anxelito/EspNotificaciones/docs/designs/gato/hero.png

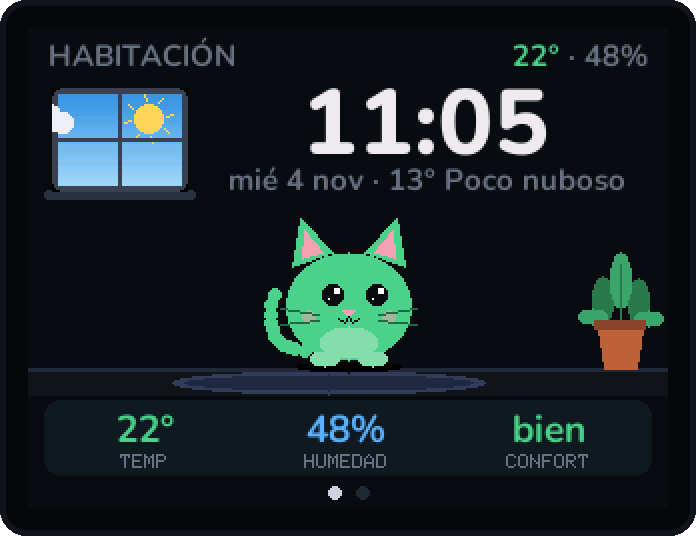
docs/designs/gato/hero.png
