anxelito/EspNotificaciones/docs/designs/perro/hero.png

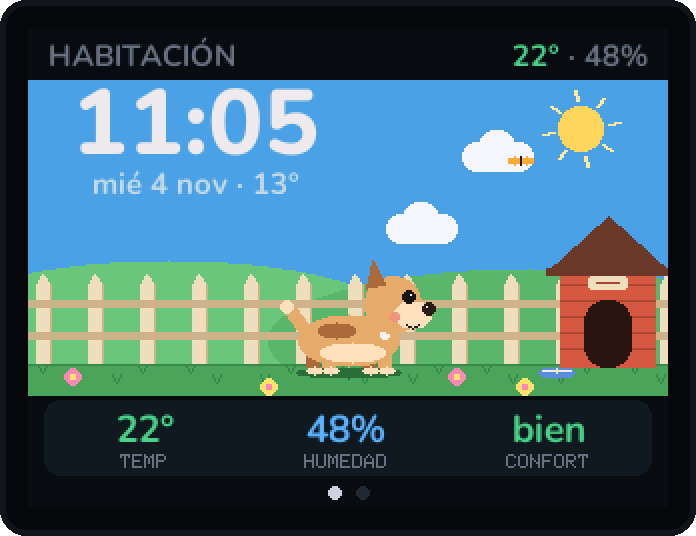
docs/designs/perro/hero.png
