anxelito/EspNotificaciones/docs/designs/pez/hero.png

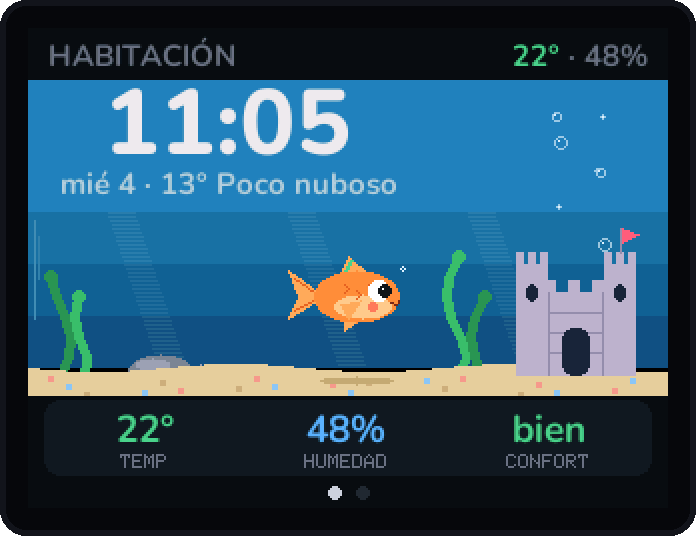
docs/designs/pez/hero.png
