anxelito/EspNotificaciones/docs/designs/pinguino/hero.png

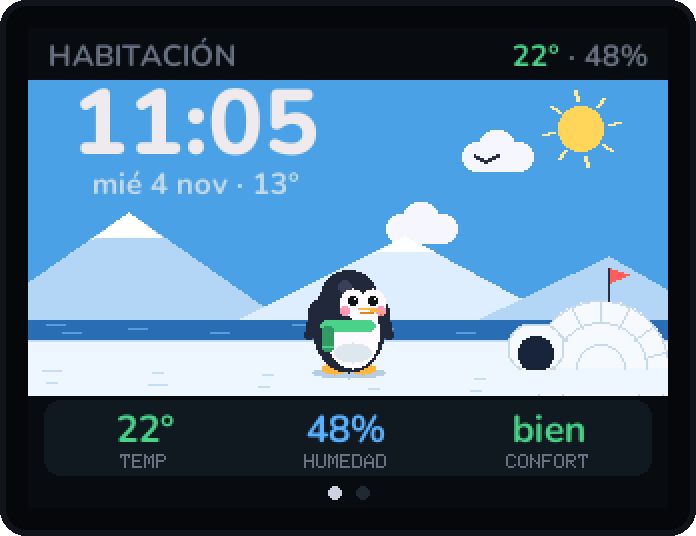
docs/designs/pinguino/hero.png
