anxelito/EspNotificaciones/docs/designs/rana/hero.png

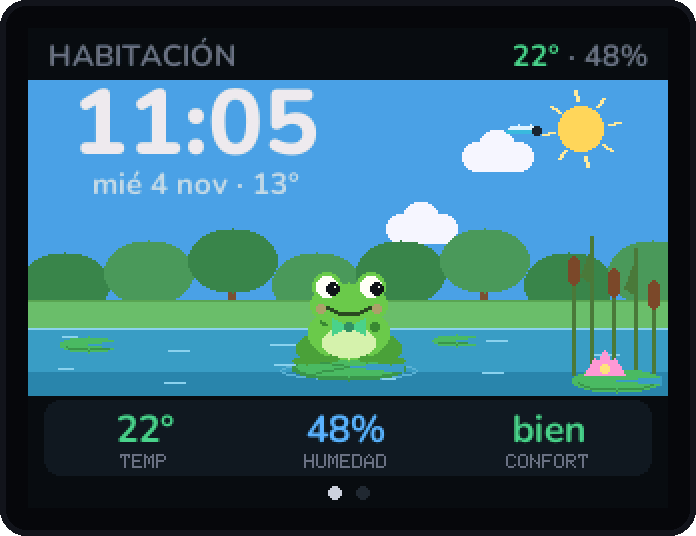
docs/designs/rana/hero.png
