anxelito/EspNotificaciones/firmware/src/main.ino

// firmware/src/main.ino
// Core 1 (loop): touch, DHT11, cat/screen state and all drawing. All
// networking lives in the core-0 worker (net/networker.*); loop() only reads
// its published snapshot and never blocks on HTTP.
#include "config.h"
#include "display.h"
#include "tasks.h"
#include "network.h"
#include "nowplaying.h"
#include "net/networker.h"
#include "logic/room.h"
#include "logic/gesture.h"
#include "logic/ui_state.h"
#include "logic/cat_state.h"
#include "logic/cat_behavior.h"
#include "hw/sensors.h"
#include "hw/touch.h"
#include "hw/backlight.h"
#include "ui/theme.h"
#include "ui/chrome.h"
#include "ui/screen_tasks.h"
#include "ui/screen_music.h"
#include "ui/screen_room.h"
#include "ui/cat_draw.h"
#include "ui/room_scene.h"
#include <SPIFFS.h>
#include <WiFi.h>

#define LOOP_IDLE_MS     2      // per-iteration yield (touch polled every pass)
#define BL_AWAKE         255
#define BL_ASLEEP        40

// --- live state -------------------------------------------------------------
static RoomReading     room;
static GestureDetector gesture;
static UiState         ui;
static CatState        cat;
static CatBehavior     catBeh;
static int             catDrawnX = ROOM_CAT_X;
static NetSnapshot     snap;             // latest copy from the worker

// --- what is currently on the glass -----------------------------------------
// Everything the header shows; redraw it only when this changes.
struct HeaderKey {
    char     title[32];
    bool     online, timeKnown, playing, haveRoom;
    int      hour, minute, temp, hum;
    Comfort  comfort;                    // temp colour can change without int change
    uint16_t bg;                         // music screen tints the header
    bool     showTime;
};

// What the room's clock/info line shows; redraw it only when this changes.
struct ClockKey {
    bool timeKnown;
    int  hour, minute, wday, mday, mon;
    bool weatherOk;
    int  code, temp;
};

static bool       drawnOnce       = false;
static Screen     drawnScreen     = Screen::ROOM;
static int        drawnDotsCount  = 0;
static uint16_t   drawnDotsBg     = 0;
static HeaderKey  drawnHeader;
static bool       headerDirty     = true;
static ClockKey   drawnClock;
static uint32_t   lastCatFrame    = 0;
static uint32_t   lastWindowFrame = 0;
static int        drawnLook       = -1;  // night*8 + comfort of the static scene
static uint32_t   lastPulse       = 0;
static int        drawnBacklight  = -1;
static TaskItem   drawnTasks[MAX_TASKS];
static int        drawnTaskCount  = -1;
static NowPlaying drawnNp;
static uint32_t   drawnSongVer    = 0;
static int        drawnProgSec    = -1;
static uint32_t   lastEqFrame     = 0;
// Progress estimate between polls: last reported value + time since then.
static int        npProgSeen      = -1;
static uint32_t   npProgAt        = 0;
static uint32_t   npProgSong      = 0;

// "Nueva tarea" toast over the header.
static int        maxTaskIdSeen   = -1;  // -1 until the first online task list
static bool       toastOn         = false;
static bool       toastDrawn      = false;
static uint32_t   toastUntil      = 0;
static char       toastText[64];

// Local artwork copy (core 1 only; decoded by TJpg on this core)
static uint8_t*   artworkBuf      = nullptr;
static int        artworkLen      = 0;
static uint32_t   artworkVersion  = 0;   // songVersion artworkBuf belongs to

static int doneCount() {
    int n = 0;
    for (int i = 0; i < snap.taskCount; i++)
        if (strcmp(snap.tasks[i].status, "done") == 0) n++;
    return n;
}

static uint16_t screenBg() {
    return ui.screen == Screen::MUSIC ? musicBg(snap.np) : C_BG;
}

static void buildHeaderKey(HeaderKey& k, bool timeKnown, int hour, int minute, bool fresh) {
    memset(&k, 0, sizeof(k));
    switch (ui.screen) {
        case Screen::ROOM:  strlcpy(k.title, "HABITACIÓN", sizeof(k.title)); break;
        case Screen::TASKS:
            if (snap.taskCount > 0)
                snprintf(k.title, sizeof(k.title), "TAREAS · %d/%d", doneCount(), snap.taskCount);
            else
                strlcpy(k.title, "TAREAS", sizeof(k.title));
            break;
        case Screen::MUSIC: strlcpy(k.title, "SONANDO", sizeof(k.title)); break;
    }
    k.online    = snap.online;
    k.timeKnown = timeKnown;
    k.hour      = timeKnown ? hour : 0;
    k.minute    = timeKnown ? minute : 0;
    k.playing   = snap.playing;
    k.haveRoom  = room.everOk && fresh;
    if (k.haveRoom) {
        k.temp    = (int)lroundf(room.tempC);
        k.hum     = (int)lroundf(room.humidity);
        k.comfort = classifyTemp(room.tempC);
    }
    k.bg = screenBg();
    k.showTime = ui.screen != Screen::ROOM;
    if (!k.showTime) { k.hour = 0; k.minute = 0; }   // minute ticks need no header redraw
}

static void buildScene(SceneInfo& s, bool timeKnown, int hour, int minute) {
    memset(&s, 0, sizeof(s));
    s.timeKnown = timeKnown && clockGetDate(&s.wday, &s.mday, &s.mon);
    s.hour = hour;
    s.minute = minute;
    s.weatherOk   = snap.weather.ok;
    s.weatherCode = snap.weather.code;
    s.outTemp     = snap.weather.temp;
    s.night       = timeKnown && (hour < 7 || hour >= 20);
    s.comfort     = roomIsFresh(room, millis()) ? classifyTemp(room.tempC) : Comfort::UNKNOWN;
}

static void buildClockKey(ClockKey& k, const SceneInfo& s) {
    memset(&k, 0, sizeof(k));
    k.timeKnown = s.timeKnown;
    if (s.timeKnown) {
        k.hour = s.hour; k.minute = s.minute;
        k.wday = s.wday; k.mday = s.mday; k.mon = s.mon;
    }
    k.weatherOk = s.weatherOk;
    if (s.weatherOk) { k.code = s.weatherCode; k.temp = (int)lroundf(s.outTemp); }
}

static int estimatedProgress(uint32_t now) {
    if (snap.np.progress_ms != npProgSeen || snap.songVersion != npProgSong) {
        npProgSeen = snap.np.progress_ms;
        npProgSong = snap.songVersion;
        npProgAt   = now;
    }
    if (snap.np.duration_ms <= 0) return 0;
    long p = (long)npProgSeen + (long)(now - npProgAt);
    return p > snap.np.duration_ms ? snap.np.duration_ms : (int)p;
}

static bool artworkReady() {
    return artworkBuf && artworkLen > 0 && artworkVersion == snap.songVersion;
}

// Copy the artwork once per song, only after the worker has published the
// artwork for the current songVersion (cheap peek first, no big copy).
static bool pickUpArtwork() {
    if (!artworkBuf || artworkVersion == snap.songVersion) return false;
    if (netArtworkVersion() != snap.songVersion) return false;
    uint32_t v = 0;
    int n = netCopyArtwork(artworkBuf, MAX_ARTWORK_BYTES, &v);
    if (v != snap.songVersion) return false;   // raced with a newer song
    artworkVersion = v;
    artworkLen     = n;
    return n > 0;
}

// New pending task (id above any seen before) -> toast. The first task list
// after boot only sets the baseline.
static void checkNewTask(uint32_t now) {
    if (!snap.online || snap.taskCount < 0) return;
    int maxId = 0;
    const TaskItem* newest = nullptr;
    for (int i = 0; i < snap.taskCount; i++) {
        if (snap.tasks[i].id > maxId) maxId = snap.tasks[i].id;
        if (snap.tasks[i].id > maxTaskIdSeen && strcmp(snap.tasks[i].status, "pending") == 0 &&
            (!newest || snap.tasks[i].id > newest->id))
            newest = &snap.tasks[i];
    }
    if (maxTaskIdSeen >= 0 && newest) {
        strlcpy(toastText, newest->text, sizeof(toastText));
        toastOn    = true;
        toastDrawn = false;
        toastUntil = now + TOAST_MS;
    }
    if (maxId > maxTaskIdSeen) maxTaskIdSeen = maxId;
}

// Robot roams horizontally, staying clear of the control panel.
static const int CAT_MIN_X = ROOM_BOT_MIN_X;
static const int CAT_MAX_X = ROOM_BOT_MAX_X;

// fullRedraw: the room was just painted, so no trail needs erasing.
static void drawCatFrame(uint32_t now, bool fullRedraw) {
    behaviorTick(catBeh, now, cat.mood == CatMood::IDLE && !toastOn, CAT_MIN_X, CAT_MAX_X);

    CatPose p;
    p.mood      = cat.mood;
    p.blink     = catBlinking(cat, now);
    p.humid     = roomIsFresh(room, now) ? classifyHumidity(room.humidity) : HumidMood::UNKNOWN;
    Comfort comfort = roomIsFresh(room, now) ? classifyTemp(room.tempC) : Comfort::UNKNOWN;
    p.body      = comfortColor(comfort);  // catDraw darkens when SLEEPING
    p.nowMs     = now;
    p.moodSince = cat.since;
    p.act       = catBeh.act;
    p.actPhase  = behaviorPhase(catBeh, now);
    p.facing    = catBeh.facing;
    p.look      = catBeh.look;
    p.comfort   = comfort;
    p.envelope  = toastOn && !catIsAsleep(cat);

    // Moving sprite: repaint the room in the strip it just left.
    int x = catBeh.x;
    if (!fullRedraw && x != catDrawnX) {
        if (x > catDrawnX) sceneRepaintRect(catDrawnX, ROOM_CAT_Y, x - catDrawnX, CAT_H);
        else               sceneRepaintRect(x + CAT_W, ROOM_CAT_Y, catDrawnX - x, CAT_H);
    }
    catDraw(p, x, ROOM_CAT_Y);
    catDrawnX = x;
}

static void render(uint32_t now, bool timeKnown, int hour, int minute, bool newArt) {
    const bool fresh       = roomIsFresh(room, now);
    const bool screenNew   = !drawnOnce || ui.screen != drawnScreen;
    const int  dotsCount   = uiScreenCount(snap.playing);

    // Header (or the toast over it).
    if (toastOn && (int32_t)(now - toastUntil) >= 0) {
        toastOn = false;
        headerDirty = true;
    }
    if (toastOn) {
        if (!toastDrawn) {
            drawToast("Nueva tarea", toastText, C_OK);
            toastDrawn = true;
        }
    } else {
        HeaderKey hk;
        buildHeaderKey(hk, timeKnown, hour, minute, fresh);
        if (screenNew || headerDirty || memcmp(&hk, &drawnHeader, sizeof(hk)) != 0) {
            HeaderInfo hi = {};
            hi.title     = hk.title;
            hi.online    = snap.online;
            hi.timeKnown = timeKnown;
            hi.hour      = hour;
            hi.minute    = minute;
            hi.playing   = snap.playing;
            hi.room      = &room;
            hi.roomFresh = fresh;
            hi.bg        = hk.bg;
            hi.showTime  = hk.showTime;
            drawHeader(hi);
            drawnHeader = hk;
            headerDirty = false;
        }
    }

    // Body.
    switch (ui.screen) {
        case Screen::ROOM: {
            SceneInfo sc;
            buildScene(sc, timeKnown, hour, minute);
            ClockKey ck;
            buildClockKey(ck, sc);
            int look = (sc.night ? 8 : 0) + (int)sc.comfort;
            if (screenNew || look != drawnLook) {      // whole room (rare)
                sceneSetLook(sc.night, sc.comfort);
                drawnLook = look;
                drawRoomScreen();                      // static room, invalidates strip
                drawRoomStrip(room, fresh);
                drawRoomClock(sc);
                drawnClock = ck;
                drawSceneAnim(now);
                lastWindowFrame = now;
                drawCatFrame(now, true);
                lastCatFrame = now;
            } else {
                if (memcmp(&ck, &drawnClock, sizeof(ck)) != 0) {
                    drawRoomClock(sc);
                    drawnClock = ck;
                }
                if ((now - lastWindowFrame) >= WINDOW_FRAME_MS) {
                    drawSceneAnim(now);
                    lastWindowFrame = now;
                }
                if ((now - lastCatFrame) >= CAT_FRAME_MS) {
                    drawRoomStrip(room, fresh);        // repaints changed columns only
                    drawCatFrame(now, false);
                    lastCatFrame = now;
                }
            }
            break;
        }

        case Screen::TASKS:
            if (screenNew || snap.taskCount != drawnTaskCount ||
                memcmp(snap.tasks, drawnTasks, sizeof(drawnTasks)) != 0) {
                drawTasksScreen(snap.tasks, snap.taskCount);
                memcpy(drawnTasks, snap.tasks, sizeof(drawnTasks));
                drawnTaskCount = snap.taskCount;
            } else if ((now - lastPulse) >= PULSE_FRAME_MS) {
                drawTasksPulse(now);
                lastPulse = now;
            }
            break;

        case Screen::MUSIC: {
            int prog = estimatedProgress(now);
            bool bgChanged = musicBg(snap.np) != musicBg(drawnNp);
            if (screenNew || snap.songVersion != drawnSongVer || bgChanged ||
                (newArt && artworkReady())) {          // artwork arrived after the text
                bool ok = artworkReady();
                drawMusicScreen(snap.np, ok ? artworkBuf : nullptr, ok ? artworkLen : 0, prog);
                drawnNp       = snap.np;
                drawnSongVer  = snap.songVersion;
                drawnProgSec  = prog / 1000;
                lastEqFrame   = now;
            } else {
                if ((now - lastEqFrame) >= EQ_FRAME_MS) {
                    drawMusicEq(snap.np, now);
                    lastEqFrame = now;
                }
                if (prog / 1000 != drawnProgSec || snap.np.duration_ms != drawnNp.duration_ms) {
                    drawMusicProgress(snap.np, prog);
                    drawnProgSec = prog / 1000;
                    drawnNp      = snap.np;
                }
            }
            break;
        }
    }

    // Page dots: on screen change, when music joins/leaves the cycle, or when
    // the music tint changes.
    uint16_t bg = screenBg();
    if (screenNew || dotsCount != drawnDotsCount || bg != drawnDotsBg) {
        drawPageDots(uiScreenIndex(ui.screen), dotsCount, bg);
        drawnDotsCount = dotsCount;
        drawnDotsBg    = bg;
    }

    drawnScreen = ui.screen;
    drawnOnce   = true;
}

void setup() {
    Serial.begin(115200);

    displayInit();
    // Cat sprite (~18 KB) first, before the worker and artwork buffers.
    uint32_t heapBefore = ESP.getFreeHeap();
    bool sprOk = catDrawInit();
    sceneInit();
    Serial.printf("[boot] cat sprite %s, heap %u -> %u B free (expect >= 40 KB)\n",
                  sprOk ? "OK" : "FAILED", (unsigned)heapBefore,
                  (unsigned)ESP.getFreeHeap());
    drawSplash("Iniciando...");

    sensorsInit();
    touchInit();
    backlightInit();

    SPIFFS.begin(true);  // format on first run if needed
    static TaskItem cached[MAX_TASKS];
    int cachedCount = loadTasks(cached);
    sortTasks(cached, cachedCount);

    artworkBuf = (uint8_t*)malloc(MAX_ARTWORK_BYTES);
    if (!artworkBuf) Serial.println("ERROR: no heap for artwork buffer");

    // Bring up the network stack here (core 1, before the worker exists) so
    // configTime() sets TZ without racing localtime_r() on the other core.
    WiFi.mode(WIFI_STA);
    clockBegin();

    netStart(cached, cachedCount);       // worker connects WiFi on core 0

    uint32_t now = millis();
    ui.screen      = Screen::ROOM;       // home
    ui.lastTouchMs = now;
    cat.since      = now;
    behaviorInit(catBeh, ROOM_CAT_X, esp_random(), now);
    Serial.printf("[boot] ready, heap %u B free\n", (unsigned)ESP.getFreeHeap());
}

void loop() {
    uint32_t now = millis();

    sensorsPoll(room, now);              // self-throttled to DHT_READ_MS

    // Touch every pass. snap.playing is from the previous pass (<= a few ms old).
    switch (gesture.update(touchPressed(), now)) {
        case Gesture::TAP:
            if (uiOnTap(ui, snap.playing, catIsAsleep(cat), now) == TapEffect::WOKE_CAT)
                catOnWakeTap(cat, now);
            break;
        case Gesture::LONG_PRESS:
            ui.lastTouchMs = now;        // any touch counts as activity
            if (ui.screen == Screen::ROOM) catOnPet(cat, now);
            break;
        default:
            break;
    }

    netGetSnapshot(&snap);

    int hour = 0, minute = 0;
    bool timeKnown = clockGetHM(&hour, &minute);

    catUpdate(cat, isSleepHour(timeKnown ? hour : -1), now);
    uiTick(ui, snap.playing, now);       // idle timeout / music ended -> ROOM

    int bl = catIsAsleep(cat) ? BL_ASLEEP : BL_AWAKE;
    if (bl != drawnBacklight) {
        backlightSet((uint8_t)bl);
        drawnBacklight = bl;
    }

    checkNewTask(now);
    bool newArt = pickUpArtwork();
    render(now, timeKnown, hour, minute, newArt);

    delay(LOOP_IDLE_MS);
}
