anxelito/EspNotificaciones/firmware/tools/snapshots/gen_readme.py

"""Writes README.md for a branch. usage: gen_readme.py <out README.md> <active id>"""
import sys

out, active = sys.argv[1], sys.argv[2]

DESIGNS = [
    ("robot", "E", "Robot en la estación", "design/robot",
     "Un robot que flota en una estación espacial, con un ojo de buey al espacio. El planeta cambia de color con la temperatura de la habitación y el panel parpadea.",
     "Vuela de lado a lado, escanea con la pantalla, se queda sin batería, estira los brazos y bota. Por la noche se sienta en su base a cargar, con gorro de dormir."),
    ("gato", "A", "Gatito en su cuarto", "design/gato",
     "El diseño original: una ventana con el cielo según la hora y el tiempo real, una alfombra y una planta.",
     "Pasea, mira alrededor, se lava, bosteza, se estira y salta. Por la noche se duerme en su cojín."),
    ("perro", "B", "Perrito en el jardín", "design/perro",
     "Exterior a pantalla completa. El cielo, las nubes, la lluvia (con charcos) y la nieve (en el césped y el tejado) siguen al tiempo real. Valla, colinas y caseta.",
     "Trota, levanta una oreja, se rasca, bosteza, hace la reverencia de juego y salta. Por la noche se enrosca en su cojín. Si hace frío, bufanda y vaho; si hace calor, lengua fuera."),
    ("pinguino", "C", "Pingüino en el polo", "design/pinguino",
     "Montañas de hielo, mar, nieve e iglú. Las noches despejadas tienen aurora boreal animada y, si la habitación está caliente, aparecen charcos de deshielo.",
     "Camina como un pato, se acicala, abre el pico, se pone de puntillas y salta. Duerme sentado con gorro. Con frío le salen chispitas de felicidad; con calor suda y se abanica."),
    ("pez", "D", "Pececito en la pecera", "design/pez",
     "Toda la pantalla es agua. Su color sigue a la temperatura de la habitación (más azul con frío, más verde con calor, más oscura de noche). Hay arena, algas, un castillo y burbujas.",
     "Nada de lado a lado, mira, echa burbujas, bosteza, abre las aletas y da un acelerón. Por la noche descansa en la arena."),
    ("rana", "F", "Rana en el estanque", "design/rana",
     "Estanque con nenúfares, juncos, flor de loto y árboles. Cuando llueve salen anillos en el agua. De día vuela una libélula y de noche hay luciérnagas.",
     "Rema en su nenúfar, caza moscas con la lengua, croa inflando la papada, estira las patas y pega saltos enormes. Por la noche duerme tapada con una hoja."),
]
STILLS = [("dia", "Día"), ("noche", "Noche"), ("frio", "Frío"), ("calor", "Calor"),
          ("carino", "Caricia"), ("tarea", "Nueva tarea")]

by_id = {d[0]: d for d in DESIGNS}
act = by_id[active]
L = []
w = L.append

PAGES = "https://anxelito.github.io/EspNotificaciones"
w('<h1 align="center">Panel de escritorio ESP32</h1>')
w("")
w('<p align="center"><b>Una mascota animada en tu mesa que te enseña la hora, el tiempo, la temperatura de tu cuarto, tus tareas de Telegram y lo que suena en Spotify.</b></p>')
w("")
w('<p align="center">')
w('  <a href="https://github.com/anxelito/EspNotificaciones/actions/workflows/tests.yml"><img alt="Tests" src="https://github.com/anxelito/EspNotificaciones/actions/workflows/tests.yml/badge.svg"></a>')
w('  <a href="LICENSE"><img alt="Licencia MIT" src="https://img.shields.io/badge/licencia-MIT-4fd18b"></a>')
w('  <img alt="ESP32" src="https://img.shields.io/badge/ESP32-PlatformIO-ff8a3d">')
w('  <img alt="Pantalla" src="https://img.shields.io/badge/pantalla-ST7789%202.4%22-5ab0ff">')
w('  <img alt="Backend" src="https://img.shields.io/badge/backend-FastAPI-b48cff">')
w('  <a href="%s/"><img alt="Pruébalo online" src="https://img.shields.io/badge/pru%%C3%%A9balo-online-ff6b8a"></a>' % PAGES)
w('</p>')
w("")
w('<p align="center"><img src="docs/designs/%s/hero.png" width="560" alt="Pantalla Habitación: %s"></p>' % (active, act[2]))
w("")
w('<p align="center">')
w('  <a href="#pruébalo">Pruébalo</a> ·')
w('  <a href="#diseños-de-la-habitación">Diseños</a> ·')
w('  <a href="#monta-el-tuyo">Monta el tuyo</a> ·')
w('  <a href="docs/INSTALACION.md">Guía completa</a> ·')
w('  <a href="#preguntas-frecuentes">Preguntas frecuentes</a>')
w('</p>')
w("")
w("> **Esta rama:** diseño **%s · %s**. Cada diseño de la pantalla Habitación vive en su propia rama `design/<nombre>`; consulta la [galería](#diseños-de-la-habitación)." % (act[1], act[2]))
w("")
w("## Pruébalo")
w("")
w("**Sin hardware, en el navegador:**")
w("- [**Simulador del panel**](%s/simulador/): el robot en su estación. Cambia la hora, la temperatura, la humedad y el tiempo; tócalo, acarícialo o mándale una tarea." % PAGES)
w("- [**Visor 3D de cajas**](%s/caja/): seis ideas de carcasa imprimible, para girarlas, cambiarles el color y la inclinación." % PAGES)
w("")
w("**Con hardware:** cuesta unos 15 € en piezas y se monta en una tarde. Ve a [Monta el tuyo](#monta-el-tuyo).")
w("")
w("## Qué hace")
w("")
w("| Pantalla | Qué muestra |")
w("|---|---|")
w("| **Habitación** | Reloj grande, fecha y tiempo de tu ciudad; la mascota con su escena; temperatura, humedad y confort del DHT11 |")
w("| **Tareas** | Las tareas que mandas al bot de Telegram, con prioridad, progreso y aviso cuando llega una nueva |")
w("| **Música** | La canción de Spotify (o Last.fm en la versión gratuita): portada grande, fondo difuminado, ecualizador y barra de progreso |")
w("")
w("- Un **toque** en el botón cambia de pantalla.")
w("- Si **mantienes pulsado** más de 1 s en Habitación, acaricias a la mascota.")
w("")
w("### Cómo reacciona la mascota")
w("")
w("- **Por la noche** (23:00–8:00) se duerme. Un toque la despierta un momento.")
w("- **Según la temperatura** de la habitación: tiembla con frío y suda con calor. Además, un detalle de su ropa (collar, bufanda, pajarita…) toma el color del confort.")
w("- **Cuando llega una tarea**, la trae en un sobre.")
w("")
w("## Diseños de la Habitación")
w("")
w("Hay seis mascotas con su propio escenario. Todas comparten el mismo comportamiento (estados de ánimo y acciones). Solo cambia el dibujo: `room_scene.*` y `cat_draw.cpp`.")
w("")
w("| | | |")
w("|:-:|:-:|:-:|")
for row in range(2):
    cells = []
    for d in DESIGNS[row * 3:(row + 1) * 3]:
        mark = " ⭐" if d[0] == active else ""
        cells.append('<img src="docs/designs/%s/dia.gif" width="260" alt="%s"><br>**%s · %s**%s<br>[`%s`](../../tree/%s)'
                     % (d[0], d[2], d[1], d[2], mark, d[3], d[3]))
    w("| " + " | ".join(cells) + " |")
w("")
w("⭐ = el diseño de esta rama. Los GIF son capturas reales del firmware: el código de dibujo se compila en el PC (ver [herramientas](#herramientas)).")
w("")
for d in DESIGNS:
    w("### %s · %s" % (d[1], d[2]))
    w("")
    w(d[4])
    w("")
    w("**Qué hace:** " + d[5])
    w("")
    w("| " + " | ".join(lab for _, lab in STILLS[:3]) + " |")
    w("|:-:|:-:|:-:|")
    w("| " + " | ".join('<img src="docs/designs/%s/%s.png" width="250" alt="%s, %s">' % (d[0], k, d[2], lab.lower()) for k, lab in STILLS[:3]) + " |")
    w("| **" + "** | **".join(lab for _, lab in STILLS[3:]) + "** |")
    w("| " + " | ".join('<img src="docs/designs/%s/%s.png" width="250" alt="%s, %s">' % (d[0], k, d[2], lab.lower()) for k, lab in STILLS[3:]) + " |")
    w("")
    w("<details><summary>De noche (animado)</summary>")
    w("")
    w('<img src="docs/designs/%s/noche.gif" width="400" alt="%s durmiendo">' % (d[0], d[2]))
    w("</details>")
    w("")
    w("Pruébalo: `git checkout %s`" % d[3])
    w("")

w("## Monta el tuyo")
w("")
w("### Lo que necesitas")
w("")
w("| Pieza | Aprox. | Notas |")
w("|---|---|---|")
w("| ESP32 DevKit (38 pines) | 6 € | cualquier ESP32-WROOM vale |")
w('| Pantalla ST7789 2.4" 240×320 (SPI) | 6 € | se usa en horizontal |')
w("| DHT11 | 1.5 € | temperatura y humedad |")
w("| TTP223 | 0.5 € | botón táctil; funciona a través de 1.2 mm de plástico. Opcional: sin él, el botón BOOT de la placa hace lo mismo |")
w("| Cables dupont y un cable micro-USB | | |")
w("| Impresora 3D | | opcional, para la [caja Mini TV retro](enclosure/retro_tv) |")
w("")
w("### Cableado")
w("")
w("| Pantalla ST7789 | ESP32 | | Sensor | ESP32 |")
w("|---|---|---|---|---|")
w("| VCC | 3V3 | | DHT11 DATA | GPIO27 |")
w("| GND | GND | | TTP223 I/O | GPIO32 |")
w("| SCL / SCK | GPIO18 | | VCC de ambos | 3V3 |")
w("| SDA / MOSI | GPIO23 | | GND de ambos | GND |")
w("| CS | GPIO15 | | | |")
w("| DC | GPIO2 | | | |")
w("| RES / RST | GPIO4 | | | |")
w("| BL / LED | 3V3 | | | |")
w("")
w("Más detalle (DHT11 suelto de 4 pines, regular el brillo) en [`firmware/WIRING.md`](firmware/WIRING.md).")
w("")
w("### En 4 pasos")
w("")
w("1. **Crea un bot de Telegram:** habla con [@BotFather](https://t.me/BotFather), usa `/newbot` y guarda el token.")
w("2. **Arranca el backend** (Python 3.11+). Necesita una URL HTTPS pública:")
w("   - un VPS con dominio,")
w("   - o, para probar desde tu PC, un túnel gratis de Cloudflare.")
w("")
w("   ```bash")
w("   cd backend")
w(r"   python -m venv .venv && source .venv/bin/activate   # Windows: .venv\Scripts\activate")
w("   pip install -r requirements.txt")
w("   cp .env.example .env        # rellena el token, API_KEY, BASE_URL...")
w("   uvicorn main:app --port 8000")
w("   ```")
w("3. **Configura el firmware:**")
w("   - Copia `firmware/src/secrets.h.example` a `secrets.h`.")
w("   - Pon tu WiFi, la URL del backend y la misma `API_KEY`.")
w("4. **Flashea** con [PlatformIO](https://platformio.org/install):")
w("")
w("   ```bash")
w("   cd firmware")
w('   pio run -e esp32dev -t upload   # si falla, mantén BOOT pulsado durante "Connecting..."')
w("   ```")
w("")
w("Ya está: escribe al bot y la tarea aparece en el panel. 🎉")
w("")
w("👉 La **[guía completa](docs/INSTALACION.md)** explica cada paso:")
w("- el túnel de Cloudflare;")
w("- dejar el backend como servicio;")
w("- Spotify o Last.fm;")
w("- el tiempo de tu ciudad;")
w("- la zona horaria;")
w("- la caja impresa.")
w("")
w("### Usar el bot")
w("")
w("| Envías | Pasa |")
w("|---|---|")
w("| `Comprar leche` | tarea normal |")
w("| `Pagar la luz!` | tarea **urgente** (con `!` al final) |")
w("| `/done 3` | marca la tarea 3 como hecha |")
w("| `/delete 3` | borra la tarea 3 |")
w("| `/list` | lista las tareas |")
w("| `/clear` | borra las tareas hechas |")
w("")
w("### Cambiar de diseño")
w("")
w("```bash")
w("git checkout design/perro          # o gato, pinguino, pez, robot, rana")
w("cd firmware && pio run -e esp32dev -t upload")
w("```")
w("")
w("`firmware/src/secrets.h` no está en git, así que se conserva al cambiar de rama.")
w("")
w("## Cómo funciona")
w("")
w("```")
w("Telegram ──webhook──▶ FastAPI ──HTTPS──▶ ESP32 ──SPI──▶ ST7789")
w("Spotify / Last.fm ──▶   /nowplaying               ▲")
w("Open-Meteo ─────────▶   /weather              DHT11 + TTP223")
w("```")
w("")
w("- **[`backend/`](backend)**: FastAPI con SQLite.")
w("  - Bot de Telegram para las tareas.")
w("  - `/nowplaying`: Spotify, o Last.fm si la cuenta es gratuita. La portada llega ya compuesta a 320×200 con su color de acento.")
w("  - `/weather`: el tiempo de Open-Meteo, con caché de 10 min.")
w("- **[`firmware/`](firmware)**: PlatformIO + TFT_eSPI.")
w("  - La red va en un hilo propio, en el núcleo 0.")
w("  - Las fuentes Nunito son suaves (anti-aliasing).")
w("  - Las animaciones usan sprites, así que no parpadean.")
w("  - La lógica (estados de ánimo, comportamiento, interfaz) tiene tests en el PC: `pio test -e native`.")
w("")
w("## Herramientas")
w("")
w("| Herramienta | Para qué |")
w("|---|---|")
w("| [`firmware/tools/snapshots`](firmware/tools/snapshots) | `python firmware/tools/snapshots/snap.py` compila el código de dibujo real en el PC, con una imitación de TFT_eSPI, y genera las capturas y los GIF de `docs/` |")
w("| [`firmware/tools/simulator`](firmware/tools/simulator) | Simulador en el navegador (robot): hora, temperatura, tiempo, caricias… |")
w("| [`firmware/tools/make_fonts.py`](firmware/tools/make_fonts.py) | Genera las fuentes suaves |")
w("")
w("## Preguntas frecuentes")
w("")
w("<details><summary><b>La pantalla pone OFFLINE</b></summary>")
w("")
w("- `API_URL` tiene que acabar en `/tasks` y ser **HTTPS**.")
w("- La `API_KEY` de `secrets.h` tiene que ser la misma que la del `.env`.")
w("- El monitor serie (`pio device monitor`) muestra el código HTTP de cada fallo.")
w("</details>")
w("")
w('<details><summary><b>El flasheo falla con "Wrong boot mode" o no conecta</b></summary>')
w("")
w("Mantén pulsado el botón **BOOT** de la placa mientras sale `Connecting...` y suéltalo cuando empiece a escribir.")
w("</details>")
w("")
w("<details><summary><b>No tengo Spotify Premium</b></summary>")
w("")
w("La API de Spotify exige Premium al dueño de la app. Sin Premium:")
w('1. Conecta Spotify a [Last.fm](https://www.last.fm/settings/applications) ("scrobbling").')
w("2. Pon `LASTFM_API_KEY` y `LASTFM_USER` en el `.env`.")
w("")
w("La pantalla de música funcionará igual, con portada y progreso estimado.")
w("</details>")
w("")
w("<details><summary><b>Los colores salen invertidos o la imagen desplazada</b></summary>")
w("")
w("Hay pantallas ST7789 de varios fabricantes. Prueba en `firmware/src/User_Setup.h`:")
w("- `TFT_INVERSION_ON` o `TFT_INVERSION_OFF`;")
w("- `TFT_RGB_ORDER TFT_BGR`.")
w("</details>")
w("")
w("<details><summary><b>¿Necesito el sensor y el botón táctil?</b></summary>")
w("")
w("No.")
w("- Sin DHT11, la tira de abajo muestra `--`.")
w("- Sin TTP223, el botón BOOT de la placa sirve para tocar (corto) y acariciar (largo).")
w("</details>")
w("")
w("<details><summary><b>Quiero crear mi propia mascota</b></summary>")
w("")
w("Crea una rama y cambia solo dos cosas:")
w("- `firmware/src/ui/room_scene.*`: el escenario;")
w("- `firmware/src/ui/cat_draw.cpp`: la mascota.")
w("")
w("Para ver el resultado sin flashear, `python firmware/tools/snapshots/snap.py` genera las capturas en el PC. Si te sale una bonita, ¡manda un PR!")
w("</details>")
w("")
w("## Contribuir")
w("")
w("Se aceptan issues y PRs: nuevas mascotas, cajas o pantallas.")
w("- Lógica: `pio test -e native`.")
w("- Backend: `cd backend && pytest`.")
w("")
w("## Licencia y créditos")
w("")
w("- Código bajo licencia [MIT](LICENSE).")
w("- Fuente [Nunito](https://github.com/googlefonts/nunito) (SIL Open Font License 1.1), convertida a fuentes suaves de TFT_eSPI.")
w("- Usa [TFT_eSPI](https://github.com/Bodmer/TFT_eSPI), [TJpg_Decoder](https://github.com/Bodmer/TJpg_Decoder), [ArduinoJson](https://arduinojson.org), [FastAPI](https://fastapi.tiangolo.com), [python-telegram-bot](https://python-telegram-bot.org) y [Open-Meteo](https://open-meteo.com).")
w("")
open(out, "w", encoding="utf-8").write("\n".join(L))
print("wrote", out)
