anxelito/EspNotificaciones/(commit log)

2026-05-16 feat: esp32 non-sensitive config
2026-05-16 feat: esp32 task model, network, and display modules
2026-05-16 feat: esp32 main loop — boot sequence, poll, offline resilience
2026-05-16 fix: ArduinoJson v7 API, empty task guard, env validation, NTP init, webhook state
    [main.ino, network.cpp, tasks.cpp]
2026-05-16 feat: initialize design documentation and configure firmware display driver for ESP32 task panel
2026-11-03 feat: spotify now playing screen + room/cat design and plan
    Also fix TFT_eSPI setup include (force-include src/User_Setup.h) so
    the firmware builds.
    [config.h, display.cpp, display.h, main.ino, network.cpp, network.h, nowplaying.h]
2026-11-04 feat: dht11, touch and backlight drivers
2026-11-04 fix: tolerate transient now-playing poll failures
    [config.h, networker.cpp]
2026-11-04 feat: room cat panel with touch navigation
    Wire DHT11, TTP223 gestures, screen/cat state machines and backlight into
    loop(); boot lands on Habitacion. Spotify no longer auto-switches (only the
    header note). Artwork copied once per song via netArtworkVersion() peek.
    Remove ScreenMode, NTP_SYNC_INTERVAL and UI_REFRESH_MS. Add Spanish
    acceptance checklist to WIRING.md.
    [cat_draw.cpp, cat_draw.h, config.h, main.ino, networker.cpp, networker.h, nowplaying.h]
2026-11-04 fix: cat darkening once, tasks offline tolerance, rounded temp colour, shared UTF-8 fitText
    [cat_draw.h, chrome.cpp, config.h, main.ino, networker.cpp, screen_music.cpp, screen_room.cpp, screen_tasks.cpp]
2026-11-04 build: pin platform and library versions
2026-11-04 fix: longer HTTP timeout, log task fetch errors, spaced header clock
    ESP32 TLS handshake can exceed 3 s; raise HTTP_TIMEOUT_MS to 8 s (network
    worker runs on core 0, so UI/touch are unaffected). Log HTTP code / JSON
    error on failed task fetch. Draw header time as HH : MM with padding since
    font 2's colon hugs the digits.
    [chrome.cpp, config.h, network.cpp]
2026-11-04 feat: BOOT button doubles as touch input; pull-down on touch pin
    Lets the panel be navigated before the TTP223 is wired, and keeps an
    unconnected touch pin from floating into phantom taps.
2026-11-04 feat: bigger wrapped text on tasks and music screens
    Task text and song title/artist use font 4 and word-wrap onto a second
    line instead of being cut with '~'; only a final line that still does not
    fit ends in '...'. Task cards grow with their text; music text may use the
    full card height when there is no progress bar. Backend ASCII-folds task
    text too, since the panel fonts have no accents.
2026-11-04 feat: livelier cat - roams, looks around, grooms, yawns, stretches, hops
    New host-tested logic/cat_behavior picks a random act between 2.5-7 s
    rests while the cat is awake and idle: walk across the room (sprite moves,
    vacated strip erased), look left/right, groom with a raised paw, yawn,
    stretch or hop. Tail swings to the side opposite the facing direction.
    Cold makes it shiver with little breath puffs; heat makes it pant.
2026-11-04 fix: music screen stays up while playing; debounce 'stopped'
    The 30 s idle return no longer applies to the music screen while something
    plays. A single not-playing poll (Last.fm drops 'now playing' between
    tracks) no longer kicks the panel off music: it takes 6 polls (~18 s).
    [config.h, networker.cpp]
2026-11-04 feat: hub redesign - smooth fonts, room scene, weather, cover tint, toasts
    - Anti-aliased Nunito fonts (OFL) with accents, generated by
    tools/make_fonts.py into ui/font_data.h; backend keeps Latin-1 text.
    - Habitacion becomes a room: animated window with sky by hour and live
    weather (rain, snow, fog, storm, sun/moon, stars), big clock with date and
    outside temperature, floor, rug and plant painted behind the cat sprite;
    cushion bed when asleep.
    - Backend /weather (Open-Meteo, WEATHER_LAT/LON) polled every 10 min.
    - Music screen tinted with the cover's main colour (backend 'accent').
    - 'Nueva tarea' banner over the header for 6 s, cat holds an envelope.
    - Tasks: done/total in the titl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
    [cat_draw.cpp, cat_draw.h, chrome.cpp, chrome.h, config.h, main.ino]
2026-11-04 fix: fonts no longer pushed down; no header clock on Habitacion
    TFT_eSPI seeds maxAscent from the VLW header ascent, so the font's
    typographic ascent (much taller than the digits) shifted the big clock
    ~14 px down onto the date line. The generator now writes the tallest
    glyph as header ascent. Habitacion hides the header time (it has the big
    clock); OFFLINE and the music note still show.
    [chrome.cpp, chrome.h, main.ino]
2026-11-04 feat: robot mascot in a space station (design E)
    The room becomes a station: round window with stars and a ringed planet
    (colour follows the room temperature, darker side at night), metal floor,
    blinking control panel. The mascot is a hovering robot with a screen face
    reusing the cat's moods and idle acts (fly, glance, scan, low battery,
    stretch, bounce; heart eyes when petted; docks and charges at night).
    Clock and info line sit left of the window; the info line drops the month,
    then the sky word, until it fits, so it never runs off the screen.
2026-11-04 feat: music screen with blurred-cover backdrop, equaliser, progress
    Backend composes one 320x200 JPEG per song: blurred darkened cover filling
    the screen, the sharp cover with a soft shadow on top, fading into a solid
    'bg' colour where the panel draws its text. Last.fm tracks now get a
    duration (track.getInfo, iTunes fallback) and an estimated progress (time
    since first seen); covers missing on Last.fm come from iTunes.
    Panel: draws the composed image, title, artist with animated equaliser,
    and a progress bar that advances locally between polls.
    [config.h, main.ino, network.cpp, nowplaying.h, screen_music.cpp]
2026-11-04 feat: clearly sleeping robot (night cap, closed eyes) + browser simulator
    Asleep, the robot now slumps on its dock with a drooping night cap and
    pompom, closed 'u' eyes on a slowly breathing screen, antenna flopped and
    off, bigger Zzz. firmware/tools/simulator/index.html mirrors the room
    scene, robot and mood/behaviour logic in a browser for quick previews
    (hour, temperature, humidity, weather, tap / pet / new task).
2026-11-04 feat: mini retro TV enclosure (Fusion 360 script)
    Parametric Fusion 360 script that builds the panel's case: shelled TV
    body with screen window in a sunken CRT bezel, touch knob (TTP223 behind a
    1.2 mm wall), speaker slots, side grille for the DHT11, screw posts,
    screen posts and ESP32 rails; back lid with lip, vents and micro-USB
    opening; rabbit-ear antenna and four plug-in legs. Printable without
    supports. README covers measuring, printing and assembly.
2026-11-04 feat(enclosure): lean the TV back (TILT_DEG) with longer front legs
2026-11-04 feat(enclosure): 3D viewer to compare six enclosure ideas
    Local three.js page (enclosure/viewer) with six case concepts -- mini
    retro TV, robot head, retro computer, space pod, minimal stand, vintage
    radio -- textured with a real capture of the panel screen, with colour,
    tilt and auto-rotate controls.
2026-11-04 feat(enclosure): TTP223 pocket, slide-in DHT11 cradle, ESP32 stop at USB opening
2026-11-04 feat(enclosure): lay all pieces on the bed in print orientation
2026-11-04 feat(tools): host-rendered screenshots of the Habitacion screen
    firmware/tools/snapshots compiles the real UI drawing code for the PC
    against a small TFT_eSPI shim (framebuffer, shapes, VLW smooth fonts,
    GLCD font) and saves PNG stills, animated GIFs and a framed hero image.
2026-11-04 docs: public-ready README, install guide, MIT license, Pages site, CI
    - README: badges, try-it links (online simulator + 3D enclosures), parts
    list, wiring table, 4-step quick start, bot usage, FAQ, credits.
    - docs/INSTALACION.md: step-by-step guide (Telegram bot, backend on a PC
    with a Cloudflare quick tunnel or on a server with systemd, firmware
    secrets and timezone, Spotify / Last.fm, choosing a mascot, enclosure,
    troubleshooting).
    - site/ + Pages workflow: landing page with the six mascots, the browser
    simulator and the 3D enclosure viewer.
    - Tests workflow: backend pytest, firmware logic tests and an ESP32 build.
    - firmware/tools/snapshots/gen_readme.py regenerates the README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
2026-11-04 fix(enclosure): ESP32 fits with its pins and dupont plugs
    A collision check (enclosure/retro_tv/fit_check.py, manifold3d) rebuilds
    the body and lid from retro_tv.py's parameters and drops in the screen,
    ESP32, DHT11, TTP223, dupont plugs and the USB plug. It found the ESP32
    rails sitting right under the board's pin rows, only 12 mm of room for
    plugs that need ~21, and the right pin row grazing a lid screw post.
    - Rails move between the pin rows (RAIL_OFF 8 mm, also fits narrow
    boards) and grow to 21 mm. The one under the screen starts behind it
    with a 45-degree ramp (prints without supports); the stop sits on the
    other rail.
    - ESP_CX 30 -> 28 clears the corner posts; the lid's USB ope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
2026-11-04 fix(enclosure): DHT11 module (on its PCB) rides on the back lid
    The slide-in cradle was sized for the bare sensor; the 3-pin module PCB
    (28.5 x 12.5 mm, pins at one end) does not fit there, and on the side
    wall its plugs would hit the lid or the screen's header.
    The module now slides into L-rails on the lid's inner face, top left,
    sensor face against the vents and an end stop; nothing else lives there,
    so straight or right-angle pins and either screen header side all fit.
    It sits far from the ESP32's heat. The body's old cradle is gone (the
    side grille stays for airflow). fit_check.py models the module with
    --dht-pins straight|angle and passes every combination; a deliberately
    misplaced mod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
2026-11-05 fix(enclosure): DHT11 cradle sized to the measured module (30 x 17 mm with pins)
    Length now includes the right-angle pins, so the rails stop 7 mm before
    the pin end. fit_check models the pins from that point.
2026-11-05 fix(enclosure): DHT11 cradle depth for the measured 10 mm module
    fit_check now derives the sensor, PCB and pin boxes from DHTM_STACK
    instead of fixed numbers.
2026-11-05 fix(enclosure): screen sized to the measured 63 x 38 x 5 mm module
    The glass covers almost the whole module, so there is no room for screw
    holes: the four M2 posts become L-shaped corner guides the module drops
    into, fixed with hot glue or tape. fit_check models the guides and
    assumes the glass spans the full outline.
2026-11-05 feat(enclosure): pocket on the lid for a USB-C power-in module
    The breakout drops into an open-top pocket on the lid's inner face:
    ledges under the PCB edges, side walls, rear stops. The receptacle goes
    through a tight opening and the plug moulding sits in an outside recess
    so it seats fully. fit_check models the module, plug and wires.
2026-11-05 feat(firmware): sensor diagnostics on the serial monitor
    SENSOR_DEBUG (on by default) logs whether the DHT11 data line idles high
    at boot (module powered and connected), every DHT11 reading or failed
    read, and every level change on the touch pin.
    [config.h, sensors.cpp, touch.cpp]
2026-11-07 feat(backend): copy UniFlow pendientes to the panel
    A background task pulls the user's open pendientes from UniFlow's
    Supabase (service_role key, filtered by UNIFLOW_USER_ID) that are due
    within UNIFLOW_DAYS_AHEAD days or overdue; due today, tomorrow or
    overdue become urgent. Marking one done with /done writes hecho back;
    done, deleted or moved out of the window there removes it here.
    Telegram-only tasks are untouched. Off unless configured.
